morly3/RejsaRubberTrac/3Dprint/printables/GR86/readme.md

# GR86 3D Printables

Please refer to [this example on X (formerly Twitter)](https://x.com/mmmmmorly/status/1976646581941305514),  
which shows an implementation using **ESP32-S3 FEATHER** and **MLX90640**.
