morly3/RejsaRubberTrac/pcb/Component list RejsaRubberTrac board v1.4 (2019-11-19).xlsx

Sheet: MLX90621
 |  | PCB marking |  |  | Surface mount alternatives
Always needed
 | Adafruit Bluefruit nRF52 CPU/BLE board |  | https://www.mouser.se/ProductDetail/485-3406
 | 1x12 pin header, 2,54 mm | J4 | https://www.mouser.se/ProductDetail/200-TSW11205TS
 | 1x16 pin header, 2,54 mm | J5 | https://www.mouser.se/ProductDetail/200-TSW11605TS
 | 1x6 pin header, 2,54 mm | J1 | https://www.mouser.se/ProductDetail/200-TSW10607TS | For the sandwich mounting of temperature and distance sensor daugther boards.
 | 2x4 pin header, 2,54 mm | J6 | https://www.mouser.se/ProductDetail/200-TSW10407GD
 | Shunt jumpers |  | https://www.mouser.se/ProductDetail/806-SX1100-A | BUY FOUR OF THESE!
 | 1N4007 | D3 | https://www.mouser.se/ProductDetail/750-1N4007-G |  | https://www.mouser.se/ProductDetail/512-S1B
 | 1uF | C4 | https://www.mouser.se/ProductDetail/810-FG28X7R1E105KRT6 |  | https://www.mouser.se/ProductDetail/710-885012106022
 | MLX90621-ESF-BAB temp sensor | U2 | https://www.mouser.se/ProductDetail/482-90621ESFBAB000SP | This is the 60 degree field of view version. There is also a 120 degree version available. NOTE: The temperature sensor from Mouser in the link is without daughter board. You can also buy it with a daughter board from for example: https://www.aliexpress.com/w/wholesale-MLX90621.html?SortType=price_asc&SearchText=MLX90621 https://eckstein-shop.de/GY-906LLC-BAB-IR-Array-Temperature-Sensor-Module
Power switch |  |  |  | If you run your sensors without battery and use the car's 12V which is switched off itself you really don't need a power switch. But can still be useful to reset the device of course
 | PN12SHNA03QE (switch) | S1 | https://www.mouser.se/ProductDetail/611-PN12SHNA03QE
 | rubber seal |  | https://www.mouser.se/ProductDetail/608-1211-5
 | button top |  | https://www.mouser.se/ProductDetail/611-G003A
12V power
 | MC7805BDTRKG | U1 | https://www.mouser.se/ProductDetail/863-MC7805BDTRKG | Actually a surface mount version but it's pretty big so not hard to solder. Benefit is it's thin and fits between the boards.
 | Shottky | D1 | https://www.mouser.se/ProductDetail/583-1S40-T |  | https://www.mouser.se/ProductDetail/511-STPS1L30A
 | 1N4007 | D2 | https://www.mouser.se/ProductDetail/750-1N4007-G |  | https://www.mouser.se/ProductDetail/512-S1B
 | 1uF | C1 | https://www.mouser.se/ProductDetail/810-FG28X7R1E105KRT6 |  | https://www.mouser.se/ProductDetail/710-885012106022
 | 1uF | C2 | https://www.mouser.se/ProductDetail/810-FG28X7R1E105KRT6 |  | https://www.mouser.se/ProductDetail/710-885012106022
Distance sensor
 | VL53L0XV2 / VL53L0CX | U3 | https://www.ebay.com/sch/i.html?_nkw=vl53l0xv2&_sop=15 or https://www.aliexpress.com/w/wholesale-vl53l0xv2.html?SortType=price_asc&SearchText=vl53l0xv2 | Beware: There is now a version of this board that looks the same but that has moved around what is connected to what pin. The order of pins (look carefully at the product picture on the page where you order) must be: - VIN - GND - SCL - SDA - GPIO - XSHUT
Different battery choices
 | Flat Li-Po rechargeable battery (JSP-PH 2.0 mm connector) |  | https://www.ebay.com/sch/i.html?_nkw=3.7V+lipo+battery+JST-PH+2.0&_sop=15 | The size "503035" fits in the 3D-printed housing but is a bit big capacity and size wise lasting 24 hours straight (500mAh). So you can choose smaller if you want.
 | 1x2 pin header, 2,54 mm | J2 | https://www.mouser.se/ProductDetail/200-TSW10207GS | Only needed if you have a battery with a 2.54 mm connector plug instead if the already present JST-PH 2.0 mm one.
 | 1x2 pin header, 1,27 mm | J3 | https://www.mouser.se/ProductDetail/200-FTS10201FS | Only needed if you have a battery with a 1.27 mm connector plug instead if the already present JST-PH 2.0 mm one.
 | Using AA or AAA battery size Li-Ions (not actual 1,5V batteries!!) instead of the above flat Li-Po battery one takes a lot of space on the rear side of the board
 | Li-ion battery holder AA | on rear side | https://www.mouser.se/ProductDetail/534-1087 | Only needed if you want to use a AA size Li-Ion rechargeable battery
 | Li-ion battery holder AAA | on rear side | https://www.mouser.se/ProductDetail/534-1075 | Only needed if you want to use a AAA size Li-Ion rechargeable battery
 | AAA size Li-ion rechargeable battery |  | https://www.ebay.com/sch/i.html?_nkw=li-ion+3.7V+aaa+10440&_sop=15
 | AA size Li-ion rechargeable battery |  | https://www.ebay.com/sch/i.html?_nkw=li-ion+3.7V+aa+14500&_sop=15
Changes
1.1 | Published on Github
1.2 | Added link to temperature sensors WITH daughter board
1.3 | Corrected Mouser part number for switch rubber seal
1.4 | Added warning about distance sensor board with wrong board pinout

Sheet: MLX90640
 |  | PCB marking |  |  |  |  |  | １個当たり | ４個 |  |  | Surface mount alternatives
 |  |  |  |  |  |  |  | 8385.95 | 33543.8
Always needed |  |  |  |  | 数量 | 金額 | 送料 | 小計 |  | 納期(日)
 | Adafruit Bluefruit nRF52 CPU/BLE board 3406 |  | https://www.mouser.se/ProductDetail/485-3406 | MOUSER |  | 4336.2 |  |  |  |  | nRF52832
 | ↑ |  | https://www.digikey.jp/ja/products/detail/adafruit-industries-llc/3406/7034992 | digikey | 1 | 4332.9
 | Adafruit ESP32-S3 FEATHER 8MB/0MB PSRAM 5323 |  | https://www.digikey.jp/ja/products/detail/adafruit-industries-llc/5323/16376065?_gl=1*gunwoh*_up*MQ..*_gs*MQ..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 | digikey | 1 | 2966.7 |  | 2966.7 |  | 4d | ESP32-S3
 | 1x12 pin header, 2,54 mm | J4 | https://www.mouser.se/ProductDetail/200-TSW11205TS |  | not needed |  |  |  |  |  | feather基板に付属
 | 1x16 pin header, 2,54 mm | J5 | https://www.mouser.se/ProductDetail/200-TSW11605TS |  | not needed |  |  |  |  |  | feather基板に付属
 | 1x6 pin header, 2,54 mm | J1 | https://www.mouser.se/ProductDetail/200-TSW10607TS | MOUSER | 1 | 49 |  | 49 |  |  | For the sandwich mounting of temperature and distance sensor daugther boards.
 | 2x4 pin header, 2,54 mm | J6 | https://www.mouser.se/ProductDetail/200-TSW10407GD | MOUSER | 1 | 96 |  | 96
 | Shunt jumpers |  | https://www.mouser.se/ProductDetail/806-SX1100-A | MOUSER | 4 | 2.5 |  | 10 |  |  | FL4+RL3+FR2+RR1＝10
 | 1N4007 | D3 | https://www.mouser.se/ProductDetail/750-1N4007-G |  | not needed |  |  |  |  |  | MLX90640を使うならD3はジャンパーなので不要 | https://www.mouser.se/ProductDetail/512-S1B
 | 1uF | C4 | https://www.mouser.se/ProductDetail/810-FG28X7R1E105KRT6 | MOUSER | 1 | 47 |  | 47 |  |  |  | https://www.mouser.se/ProductDetail/710-885012106022
 | MLX90640-ESF-BAA temp sensor | U2 | https://ja.aliexpress.com/item/1005008180135795.html | アリエク | 1 | 3164 | 168 | 3332 |  | 2W | 110 degree、MOUSERは5731円 | https://ja.aliexpress.com/item/1005004176046297.html
 | MLX90640-ESF-BAA temp sensor | U2 | https://ja.aliexpress.com/item/1005004176046297.html | アリエク | 0 | 3108 |  |  |  |  | 上が品切れなら
Power switch |  |  |  |  |  |  |  |  |  |  | If you run your sensors without battery and use the car's 12V which is switched off itself you really don't need a power switch. But can still be useful to reset the device of course
 | PN12SHNA03QE (switch) | S1 | https://www.mouser.se/ProductDetail/611-PN12SHNA03QE | MOUSER | 1 | 262 |  | 262
Distance sensor
 | VL53L0XV2 / VL53L0CX | U3 | https://ja.aliexpress.com/item/1005006980614596.html | アリエク | 1 | 204 | 130.5 | 334.5
Different battery choices
 | LIPO |  | https://ja.aliexpress.com/item/1005006421563695.html | アリエク | 1 | 674 | 218.5 |  |  |  | size "503035" PHコネクタ ※極性が逆なのでコネクタ差し替え
 |  |  | https://ja.aliexpress.com/item/32814862683.html | アリエク | 1 | 438 | 265.75 | 703.75 |  |  | size "503035" PHコネクタ
 | 基板 |  |  | JLCPCB | 2 | 250 | 85 | 585 |  |  | １枚はセンサマウント用に切り抜き
Changes
1.1 | Published on Github
1.2 | Added link to temperature sensors WITH daughter board
1.3 | Corrected Mouser part number for switch rubber seal
1.4 | Added warning about distance sensor board with wrong board pinout
