morly3/RejsaRubberTrac/3Dprint/printables/GR86/Main Housing Lid.step

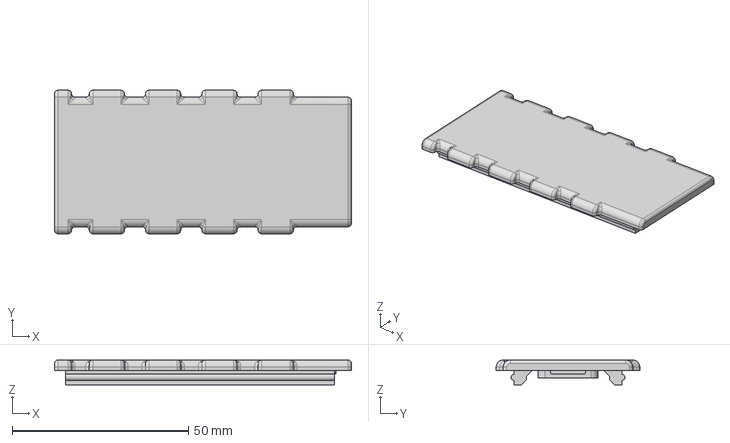
[picture p1: CAD file, 2025-10-15]
3Dprint/printables/GR86/Main Housing Lid.step
84.4 x 40.8 x 7.10 mm
