morly3/RejsaRubberTrac/3Dprint/printables/GR86/Main Housing Lid for front flap RH 12 degree.step

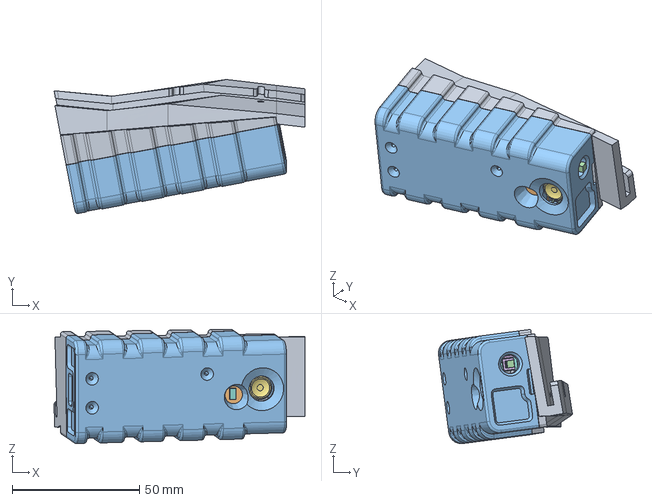
[picture p2: CAD file, 2025-10-15]
3Dprint/printables/GR86/Main Housing Lid for front flap RH 12 degree.step
98.5 x 52.6 x 44.8 mm
