morly3/RejsaRubberTrac/3Dprint/printables/GR86/Main Housing Base for Bluefruit_nRF52 and Adafruit_ESP32-S3_FEATHE.step

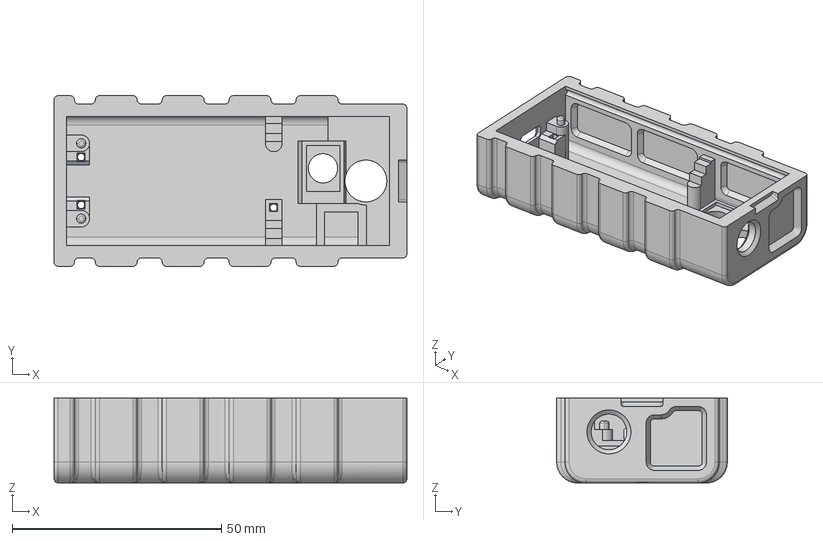
[picture p3: CAD file, 2025-10-15]
3Dprint/printables/GR86/Main Housing Base for Bluefruit_nRF52 and Adafruit_ESP32-S3_FEATHE.step
84.4 x 40.8 x 20.3 mm
