morly3/RejsaRubberTrac/3Dprint/printables/FOV Check Ruler/FOV Check Ruler110deg with case.stl

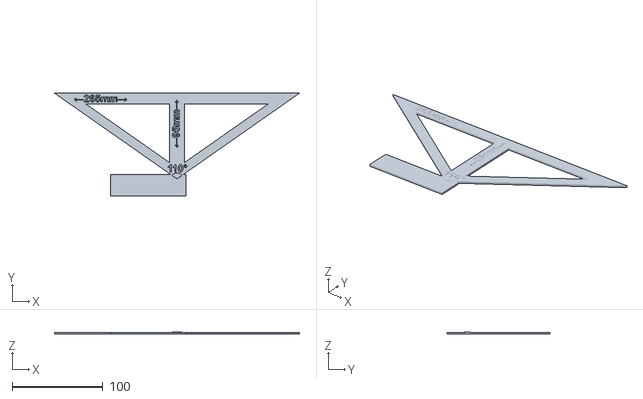
[picture p4: CAD file, 2026-01-25]
3Dprint/printables/FOV Check Ruler/FOV Check Ruler110deg with case.stl
270.0 x 113.2 x 2.50
