morly3/RejsaRubberTrac/3Dprint/printables/FOV Check Ruler/FOV Check Ruler110deg.stl

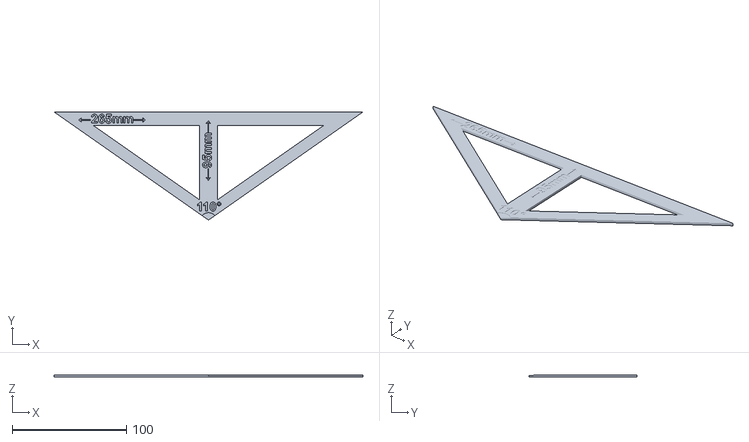
[picture p5: CAD file, 2026-01-25]
3Dprint/printables/FOV Check Ruler/FOV Check Ruler110deg.stl
270.0 x 94.5 x 2.00
