morly3/RejsaRubberTrac/3Dprint/printables/GR86/rear flap RH 3 degree.step

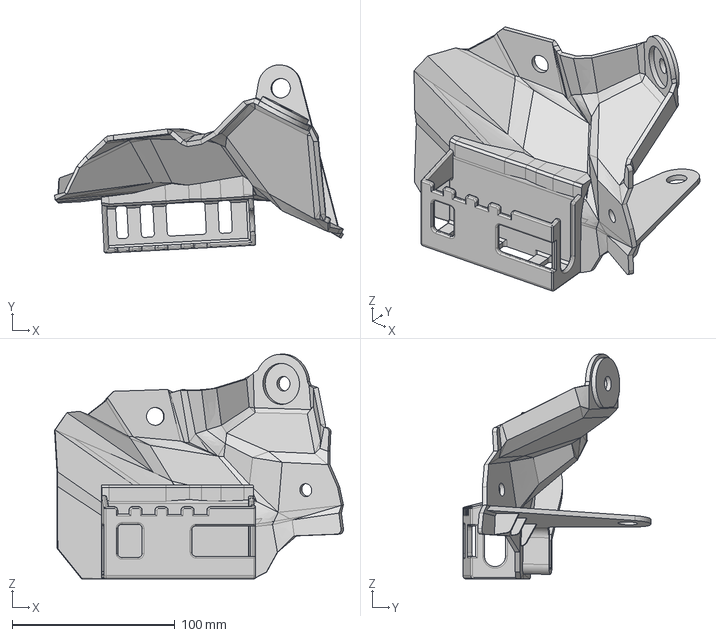
[picture p6: CAD file, 2025-10-15]
3Dprint/printables/GR86/rear flap RH 3 degree.step
177.8 x 115.8 x 138.3 mm
