morly3/RejsaRubberTrac/3Dprint/printables/GR86/button.stl

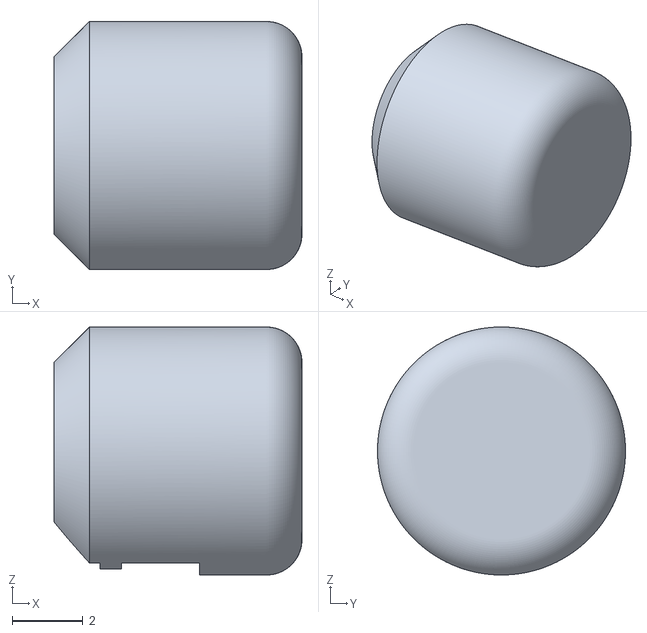
[picture p7: CAD file, 2025-09-29]
3Dprint/printables/GR86/button.stl
7.00 x 7.00 x 7.00
