morly3/RejsaRubberTrac/3Dprint/printables/GR86/Temperature Sensor Mounting Spacer 3mm for MLX90640.stl

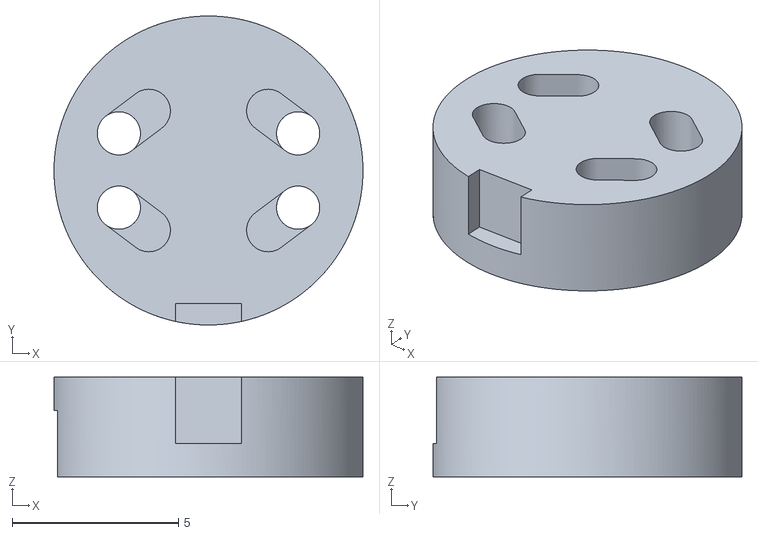
[picture p8: CAD file, 2025-07-04]
3Dprint/printables/GR86/Temperature Sensor Mounting Spacer 3mm for MLX90640.stl
9.30 x 9.30 x 3.00
