morly3/RejsaRubberTrac/(list of files, cad)

Other CAD files:
3Dprint/printables/GR86/Main Housing Base for Bluefruit_nRF52 and Adafruit_ESP32-S3_FEATHE.stl
3Dprint/printables/GR86/Main Housing Lid for front flap RH 12 degree.stl
3Dprint/printables/GR86/Main Housing Lid.stl
3Dprint/printables/GR86/rear flap RH 3 degree.stl
