morly3/RejsaRubberTrac/main/Configuration.h

#ifndef CONFIGURATION_H
#define CONFIGURATION_H

#define _DEBUG                    // Set debug mode, results in more verbose output on serial port
#include "Constants.h"

//#define DUMMYDATA       // Uncomment to enable transmission of fake random data for testing with no sensors needed


// -- Basic device configuration, see Constants.h
#define BOARD              BOARD_M5STICKS3
#define DISP_DEVICE        DISP_NONE
#define STATUS_LED         STATUS_LED_RUNNING

// -- Distance Sensor related settings

#define DIST_SENSOR        DIST_NONE // DIST_VL53L0X
#define DIST_SENSOR2       DIST_NONE // Device to use for second sensor on second I2C hardware bus (ESP32 only), see Constants.h

#define DISTANCEOFFSET 0         // Write distance to tire in mm here to get logged distance data value centered around zero
                                 // If you leave this value here at 0 the distance value in the logs will always be positive numbers

// -- Far Infrared Sensor related settings

#define FIS_SENSOR         FIS_MLX90640    // Device to use, see Constants.h    

#if (BOARD == BOARD_ESP32_LOLIND32)
  #define FIS_SENSOR2_PRESENT 0            // Set to 1 if second sensor on second I2C hardware bus is present (ESP32 only)
#else
  #define FIS_SENSOR2_PRESENT 0
#endif
#define FIS_REFRESHRATE    8            // Sets the FIS refresh rate in Hz. MLX90640 should be max 8 Hz with nRF52, max 16 Hz with ESP32-S3

#if (FIS_SENSOR == FIS_MLX90621)
  #define IGNORE_TOP_ROWS    0     // Ignore this many rows from the top of the sensor
  #define IGNORE_BOTTOM_ROWS 0     // Ignore this many rows from the bottom of the sensor
#elif (FIS_SENSOR == FIS_MLX90640)
  #define IGNORE_TOP_ROWS    10
  #define IGNORE_BOTTOM_ROWS 10
#elif (FIS_SENSOR == FIS_DUMMY)
  #define IGNORE_TOP_ROWS    0
  #define IGNORE_BOTTOM_ROWS 0
#elif (FIS_SENSOR == FIS_AMG8833)
  #define IGNORE_TOP_ROWS    2
  #define IGNORE_BOTTOM_ROWS 2
#elif (FIS_SENSOR == FIS_MLX90614)
  #define IGNORE_TOP_ROWS    0
  #define IGNORE_BOTTOM_ROWS 0
#endif

#define COLUMN_AGGREGATE   COLUMN_AGGREGATE_MAX  // Set column aggregation algorhytm, see Constants.h

//#define FIS_AUTOZOOM          // Comment to disable autozooming
#define AUTOZOOM_MINIMUM_TIRE_WIDTH 16 // Minimum tire width for autozooming

#define TEMPSCALING  1.3  // Default 1.00. Use 1.3 when sensor is inside a ziplock bag.
#define TEMPOFFSET    -3    // Default 0. Use -3 when sensor is inside a ziplock bag. NOTE: in TENTHS of degrees Celsius --> TEMPOFFSET 10 --> 1 degree-3
                  
#define MIRRORTIRE        0      // 0 = default
                                 // 1 = Mirror the tire (A), making the outside edge temps the inside edge temps
#if (FIS_SENSOR2_PRESENT == 1)
  #define MIRRORTIRE2     0      // 0 = default
                                 // 1 = Mirror tire B, making the outside edge temps the inside edge temps
#endif
                                 // NOTE!!! THESE CAN BE OVERRIDDEN WITH HARDWARE CODING WITH A GPIO PIN
                          
// -- General settings

#define DEVICENAMECODE 0      // DEFAULT is 7
                          // 7 = "RejsaRubber" + four last bytes from the bluetooth MAC address

                          // 0 = "RejsaRubberFL" + three last bytes from the bluetooth MAC address
                          // 1 = "RejsaRubberFR" + three last bytes from the bluetooth MAC address
                          // 2 = "RejsaRubberRL" + three last bytes from the bluetooth MAC address
                          // 3 = "RejsaRubberRR" + three last bytes from the bluetooth MAC address
                          // 5 = "RejsaRubberF" + one space + three last bytes from the bluetooth MAC address
                          // 6 = "RejsaRubberR" + one space + three last bytes from the bluetooth MAC address
                        
                          // NOTE!!! THIS CAN BE OVERRIDDEN WITH HARDWARE CODING WITH GPIO PINS

#define SERIAL_UPDATERATE  1    // Update rate for the serial monitor in seconds
#define BATTERY_UPDATERATE   10     // Update rate for the battery in seconds


// -- Board-specific settings

#if (BOARD == BOARD_ESP32_LOLIND32)
  #define MILLIVOLTFULLSCALE  3300
  #define STEPSFULLSCALE      4096
  #define BATRESISTORCOMP     2.000 // Compensation for a resistor voltage divider between battery and ADC input pin
  #define VBAT_PIN            35
  #define GPIOLEDDIST         -1 // ESP32 only has one LED, we prefer temp updates to be signalled
  #define GPIOLEDTEMP         LED_BUILTIN  // note: system constant LED_BUILTIN does not seem to work for some of the ESP32 boards => set pin statically here in case
  #define GPIOSDA             21 // set I2C bus GPIO pins in case of ESP32 explicitly to specific pins (different board designs have the I2C pins assigned differently)
  #define GPIOSCL             22
  #define GPIOSDA2            33 // set second I2C bus GPIO pins in case of ESP32 explicitly to specific pins (different board designs have the I2C pins assigned differently)
  #define GPIOSCL2            32
  #define GPIODISTSENSORXSHUT 15  // GPIO pin: A+B = Distance Sensor Shutdown
  #define GPIOLEFT            12  // GPIO pin: A+B Axis orientation
  #define GPIOFRONT           14  // GPIO pin: A+B Axis 1(0)/Axis 2(1)
  #define GPIOCAR             27  // GPIO pin: A+B = Car(1)
  #define GPIOMIRR            13  // GPIO pin: Mirr A
  #define GPIOMIRR2           26  // GPIO pin: Mirr B
  #define GPIOUNUSEDA2        17  // GPIO pin: Unused A2 (NOTE: works only on non-Pro LOLIN D32, because pin is NC on Pro)
  #define GPIOUNUSEDB1        25  // GPIO pin: Unused B1
#elif (BOARD == BOARD_ESP32_FEATHER)  // dafruit ESP32-S3 Feather
  #define MILLIVOLTFULLSCALE  -1
  #define STEPSFULLSCALE      -1
  #define BATRESISTORCOMP     -1
  #define VBAT_PIN            A13
  #define GPIOLEDDIST         LED_BUILTIN
  #define GPIOLEDTEMP         RGB_BUILTIN
  #define GPIOSDA             SDA // set I2C bus GPIO pins to default pins
  #define GPIOSCL             SCL
  #define GPIOSDA2            -1 // second I2C bus only available with LOLIN D32-based PCB
  #define GPIOSCL2            -1
  #define GPIODISTSENSORXSHUT SCK  // GPIO pin number (SCK/IO36 pin32)
  #define GPIOCAR             T14  // GPIO pin number (A4/IO14 pin18)
  #define GPIOFRONT           T8  // GPIO pin number (A5/IO8 pin12)
  #define GPIOLEFT            MOSI  // GPIO pin number (MOSI/IO35 pin31)
  #define GPIOMIRR            MISO  // GPIO pin number (MISO/IO37 pin33)
#elif (BOARD == BOARD_NRF52_FEATHER)
  #define MILLIVOLTFULLSCALE  3600
  #define STEPSFULLSCALE      1024
  #define BATRESISTORCOMP     1.403 // Compensation for a resistor voltage divider between battery and ADC input pin
  #define VBAT_PIN            A7
  #define GPIOLEDDIST         LED_RED
  #define GPIOLEDTEMP         LED_BLUE
  #define GPIOSDA             PIN_WIRE_SDA // set I2C bus GPIO pins to default pins
  #define GPIOSCL             PIN_WIRE_SCL
  #define GPIOSDA2            -1 // second I2C bus only available for ESP32
  #define GPIOSCL2            -1
  #define GPIODISTSENSORXSHUT 12  // GPIO pin number (SCK/P0.12 U1-26)
  #define GPIOCAR             28  // GPIO pin number (A4/P0.28 U1-5)
  #define GPIOFRONT           29  // GPIO pin number (A5/P0.29 U1-6)
  #define GPIOLEFT            13  // GPIO pin number (MOSI/P0.13 U1-27)
  #define GPIOMIRR            14  // GPIO pin number (MISO/P0.14 U1-28)
#elif (BOARD == BOARD_M5STICKS3)
  #define MILLIVOLTFULLSCALE  -1
  #define STEPSFULLSCALE      -1
  #define BATRESISTORCOMP     -1
  #define VBAT_PIN            -1
  #define GPIOLEDDIST         -1 // LED disabled
  #define GPIOLEDTEMP         -1 // LED disabled
  #define GPIOSDA             8  // MLX90640 SDA: GPIO8
  #define GPIOSCL             0  // MLX90640 SCL: GPIO0
  #define GPIOSDA2            -1
  #define GPIOSCL2            -1
  #define GPIODISTSENSORXSHUT -1
  #define GPIOCAR             -1
  #define GPIOFRONT           -1
  #define GPIOLEFT            -1
  #define GPIOMIRR            -1
#endif


// -- Dynamically calculated configuration values

#if (FIS_SENSOR == FIS_MLX90621)
  #define FIS_X           16  // Far Infrared Sensor columns
  #define FIS_Y            4  // Far Infrared Sensor rows
#elif (FIS_SENSOR == FIS_MLX90640)
  #define FIS_X           32
  #define FIS_Y           24
#elif (FIS_SENSOR == FIS_DUMMY)
  #define FIS_X           16
  #define FIS_Y            4
#elif (FIS_SENSOR == FIS_AMG8833)
  #define FIS_X            8
  #define FIS_Y            8
#elif (FIS_SENSOR == FIS_MLX90614)
  #define FIS_X            1
  #define FIS_Y            1
#endif

#define EFFECTIVE_ROWS ( FIS_Y - IGNORE_TOP_ROWS - IGNORE_BOTTOM_ROWS )
#endif /* CONFIGURATION_H */
