morly3/RejsaRubberTrac/(commit log)

2025-07-04 Temperature Sensor Mounting Spacer 3mm for MLX90640
    [Temperature Sensor Mounting Spacer 3mm for MLX90640.stl]
2025-07-06 Modified implementation to support ESP32-S3 Feather when BOARD_ESP32_FEATHER is defined.
    Fixed errors when BOARD_NRF52_FEATHER is defined.
    [Configuration.h]
2025-07-10 Included 'Operation Indicator' as one of the LED modes.
    [Configuration.h]
2025-09-29 This is a model designed to be mounted on the GR86 flap.
    The case is compatible with both the Adafruit Feather nRF52 (3406) and the Adafruit ESP32-S3 Feather 8MB/0MB PSRAM (5323).
    It is optimized for the MLX90640 with a 110° field of view. When installing the temperature sensor, it is intended to be used together with the Temperature Sensor Mounting Spacer 3mm for MLX90640.
    [Main Housing Base for Bluefruit_nRF52 and Adafruit_ESP32-S3_FEATHE.stl, Main Housing Lid for front flap 12 degree.3mf, Main Housing Lid for front flap RH 12 degree.stl, Main Housing Lid.stl, Temperature Sensor Mounting Spacer 3mm for MLX90640.stl, button.stl, rear flap RH 3 degree.stl, rear flap.3mf]
2025-10-15 add new step files.
    [Main Housing Base for Bluefruit_nRF52 and Adafruit_ESP32-S3_FEATHE.step, Main Housing Lid for front flap 12 degree.3mf, Main Housing Lid for front flap RH 12 degree.step, Main Housing Lid.step, rear flap RH 3 degree.step, rear flap.3mf]
2026-01-25 Add FOV check ruler to the 3D printer model
    [FOV Check Ruler110deg with case.stl, FOV Check Ruler110deg.stl]
2026-01-25 Add the component list for the MLX90640 to the parts list.
    [Component list RejsaRubberTrac board v1.4 (2019-11-19).xlsx]
2026-03-13 docs: add example TEMPSCALING and TEMPOFFSET values for ziplock bag usage
    [Configuration.h]
2026-09-06 ポリエチレンバッグに入れた際の温度補正
    [Configuration.h]
2026-09-06 M5StickS3に対応
    [Configuration.h]
2026-09-06 液晶表示に対応
2026-09-07 全画素読み取るモードを追加
2026-09-12 起動中にPCとUSB接続した際にフリーズする問題を修正
2026-09-15 低消費電力モードを追加 タイマーまたは振動で復帰
2026-09-21 電源オフ操作後に低消費電力モードから復帰する問題を修正
